KoHuynh/QuadCtrl/images/feedbacksystem.png

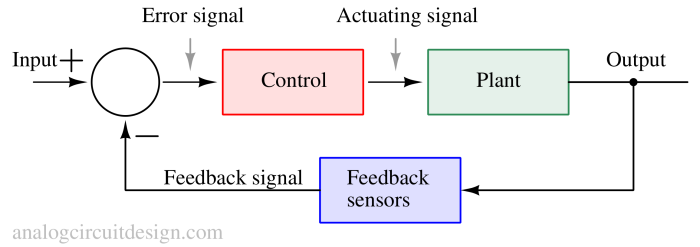
images/feedbacksystem.png
