KoHuynh/QuadCtrl/images/ECE193HQuadCopterShieldSchematicV1.pdf

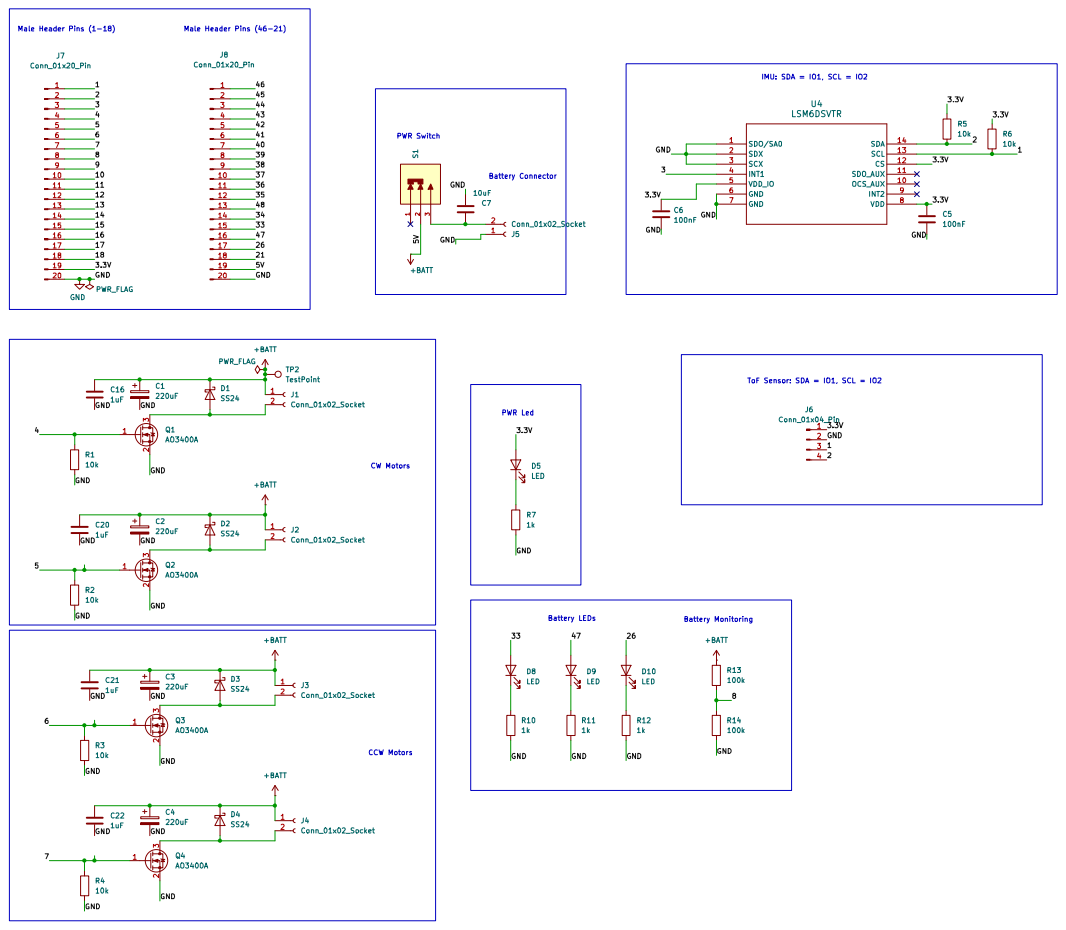
[picture p7: page 1]
