KoHuynh/QuadCtrl/ShieldDesign/ECE193HQuadCopterShieldVer1.kicad_pcb

## KiCad design ShieldDesign/ECE193HQuadCopterShieldVer1.kicad_pcb (2026-10-13)

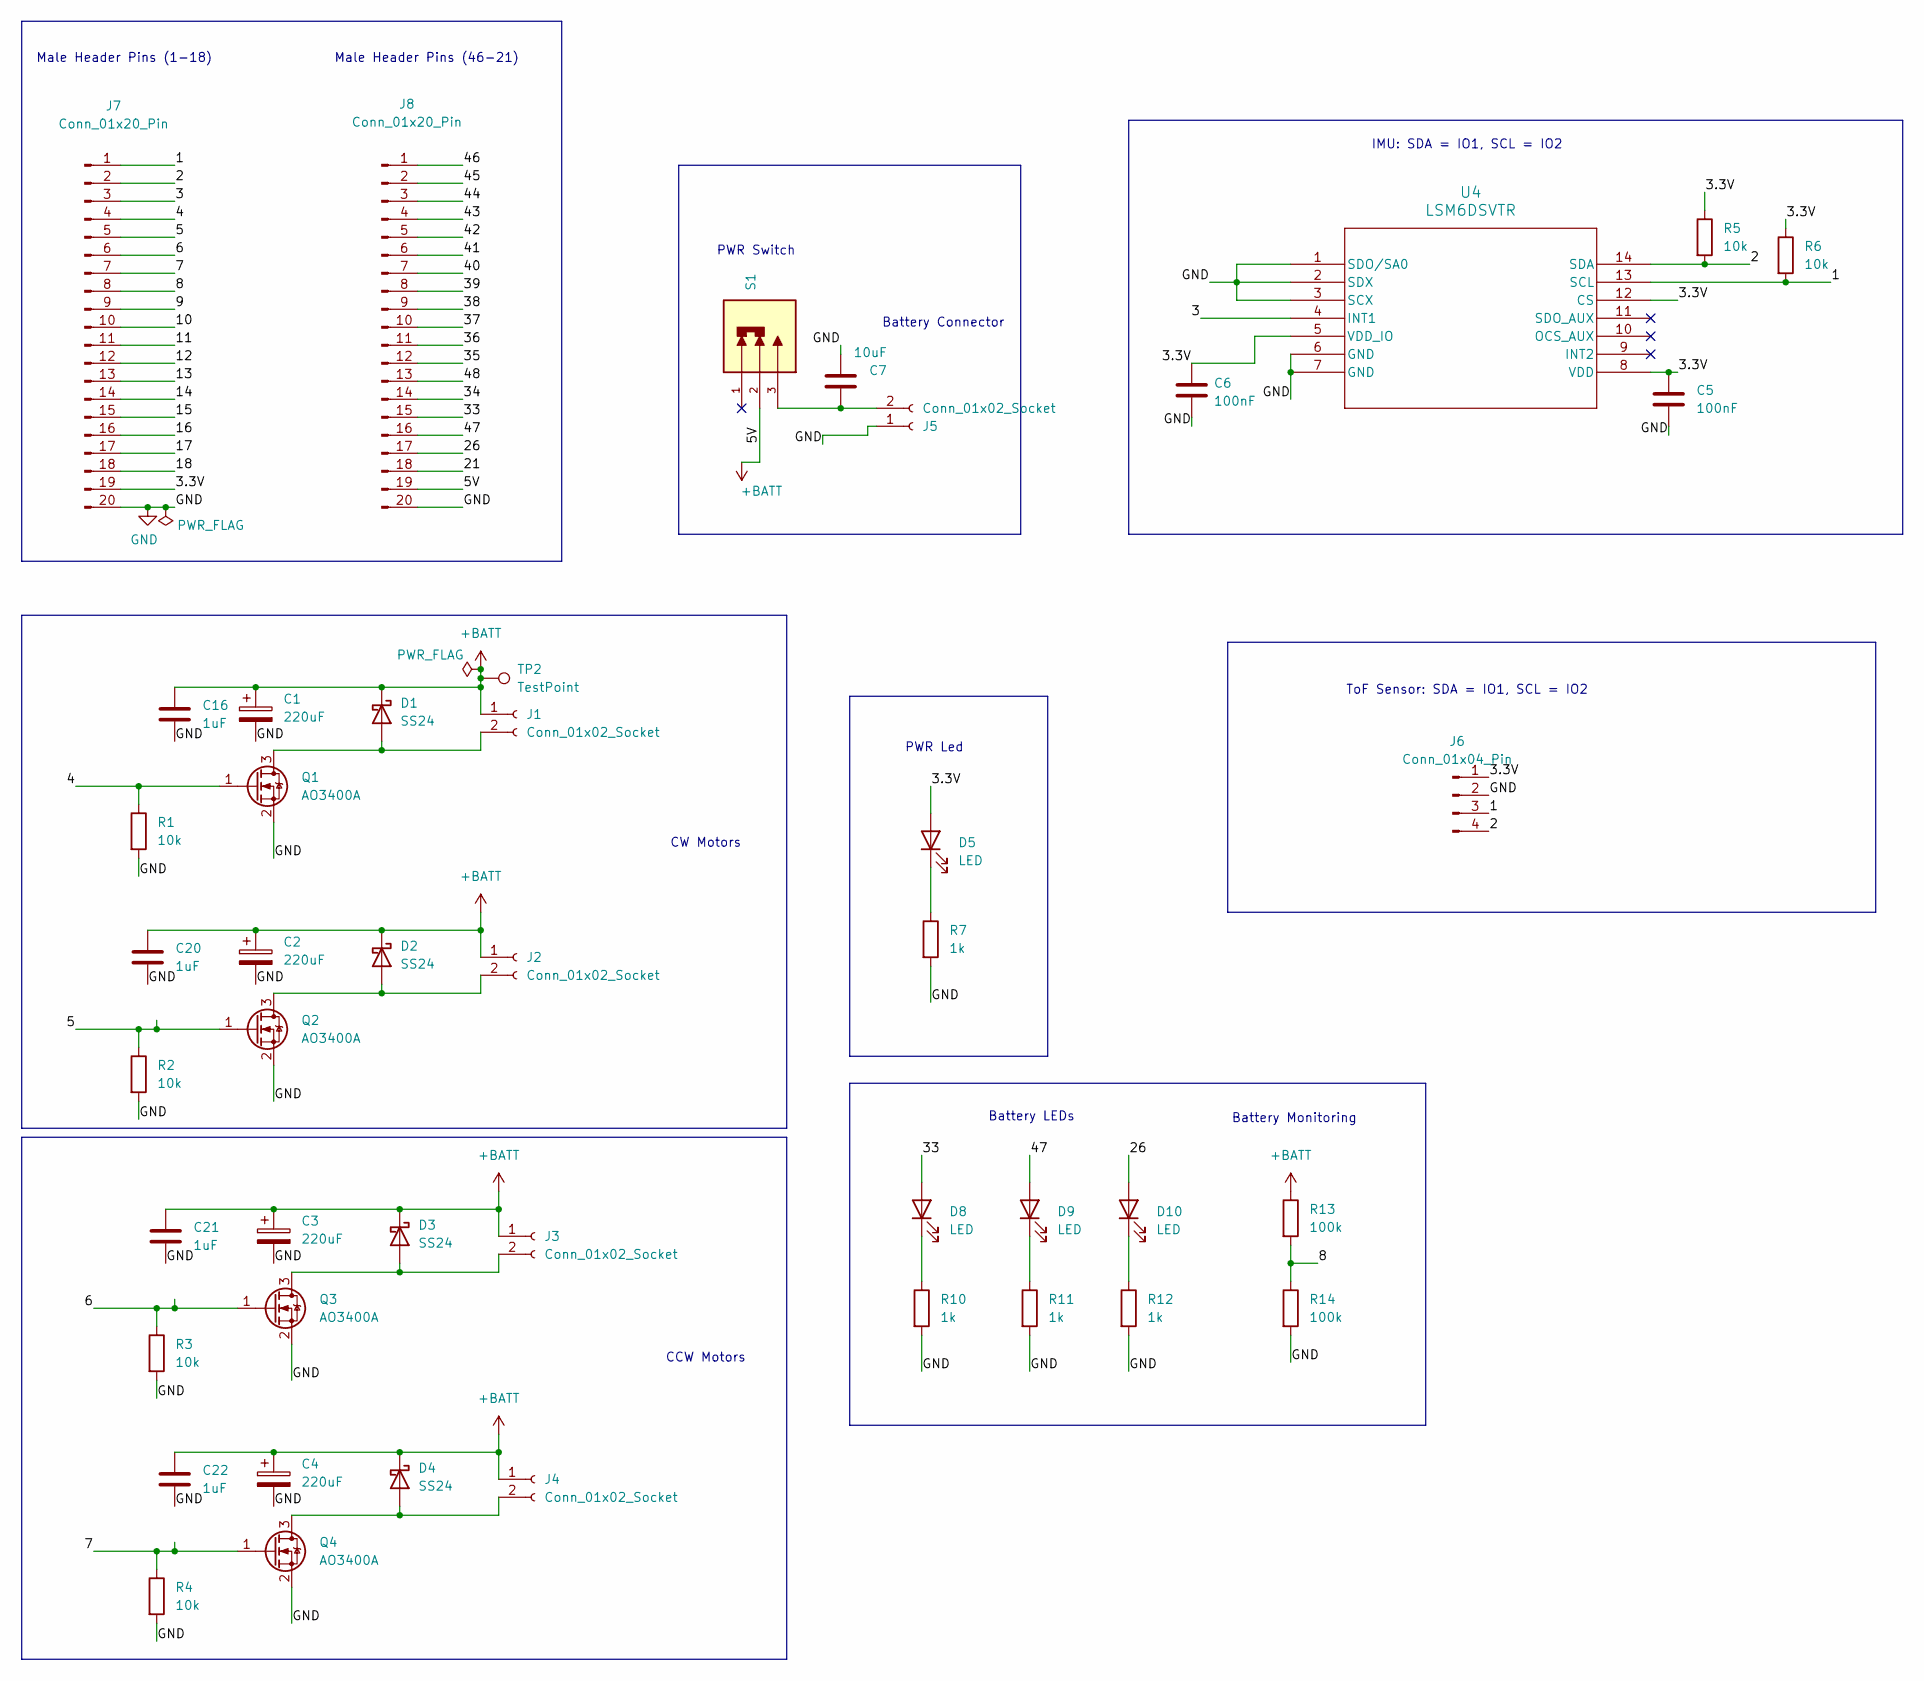
[picture p8: schematic ECE193HQuadCopterShieldVer1.kicad_sch]

Parts:
C1, C2, C3, C4: 220uF; CAP_EEEFK1A221SL
C5, C6: 100nF; C_0805_2012Metric_Pad1.18x1.45mm_HandSolder
C7: 10uF; C_0805_2012Metric_Pad1.18x1.45mm_HandSolder
C16, C20, C21, C22: 1uF; C_0805_2012Metric
D1, D2, D3, D4: SS24; D_SMA
D5, D8, D9, D10: LED; LED_0805_2012Metric
J1, J2, J3, J4, J5: Conn_01x02_Socket; PinHeader_1x02_P2.54mm_Vertical
J6: Conn_01x04_Pin; PinHeader_1x04_P2.54mm_Vertical
J7, J8: Conn_01x20_Pin; PinHeader_1x20_P2.54mm_Vertical
Q1, Q2, Q3, Q4: AO3400A; SOT-23
R1, R2, R3, R4, R5, R6: 10k; R_0805_2012Metric_Pad1.20x1.40mm_HandSolder
R7, R10, R11, R12: 1k; R_0805_2012Metric_Pad1.20x1.40mm_HandSolder
R13, R14: 100k; R_0805_2012Metric_Pad1.20x1.40mm_HandSolder
S1: SLW-105558-2A-N-D; SW_SLW-105558-2A-N-D; PARTREV 1.01
TP2: TestPoint; TestPoint_Pad_D1.0mm
U4: LSM6DSVTR; LGA14-L_2P59X3P1X0P5_STM

Connections:
+BATT: C1.1, C2.1, C3.1, C4.1, C16.1, C20.1, C21.1, C22.1, D1.1 (K), D2.1 (K), D3.1 (K), D4.1 (K), J1.1, J2.1, J3.1, J4.1, J8.19, R13.1, S1.2, TP2.1; also elsewhere on the board
/1: J6.3, J7.1, R6.2, U4.13 (SCL)
/2: J6.4, J7.2, R5.2, U4.14 (SDA)
/3: J7.3, U4.4 (INT1)
/3.3V: C5.1, C6.1, D5.2 (A), J6.1, J7.19, R5.1, R6.1, U4.5 (VDD_IO), U4.8 (VDD), U4.12 (CS)
/4: J7.4, Q1.1 (G), R1.1
/5: J7.5, Q2.1 (G), R2.1
/6: J7.6, Q3.1 (G), R3.1
/7: J7.7, Q4.1 (G), R4.1
/8: J7.8, R13.2, R14.1
/9: J7.9
/10: J7.10
/11: J7.11
/12: J7.12
/13: J7.13
/14: J7.14
/15: J7.15
/16: J7.16
/17: J7.17
/18: J7.18
/21: J8.18
/26: D10.2 (A), J8.17
/33: D8.2 (A), J8.15
/34: J8.14
/35: J8.12
/36: J8.11
/37: J8.10
/38: J8.9
/39: J8.8
/40: J8.7
/41: J8.6
/42: J8.5
/43: J8.4
/44: J8.3
/45: J8.2
/46: J8.1
/47: D9.2 (A), J8.16
/48: J8.13
GND: C1.2, C2.2, C3.2, C4.2, C5.2, C6.2, C7.2, C16.2, C20.2, C21.2, C22.2, J5.1, J6.2, J7.20, J8.20, Q1.2 (S), Q2.2 (S), Q3.2 (S), Q4.2 (S), R1.2, R2.2, R3.2, R4.2, R7.2, R10.2, R11.2, R12.2, R14.2, U4.1 (SDO/SA0), U4.2 (SDX), U4.3 (SCX), U4.6 (GND), U4.7 (GND)
unnamed: D1.2 (A), J1.2, Q1.3 (D)
unnamed: D2.2 (A), J2.2, Q2.3 (D)
unnamed: D3.2 (A), J3.2, Q3.3 (D)
unnamed: D4.2 (A), J4.2, Q4.3 (D)
unnamed: D5.1 (K), R7.1
unnamed: D8.1 (K), R10.1
unnamed: D9.1 (K), R11.1
unnamed: D10.1 (K), R12.1
unnamed: C7.1, J5.2, S1.3

Notes on the sheet:
ToF Sensor: SDA = IO1, SCL = IO2
Male Header Pins (46-21)
CW Motors
IMU: SDA = IO1, SCL = IO2
Battery LEDs
PWR Switch
Battery Connector
PWR Led
CCW Motors
Battery Monitoring
Male Header Pins (1-18)

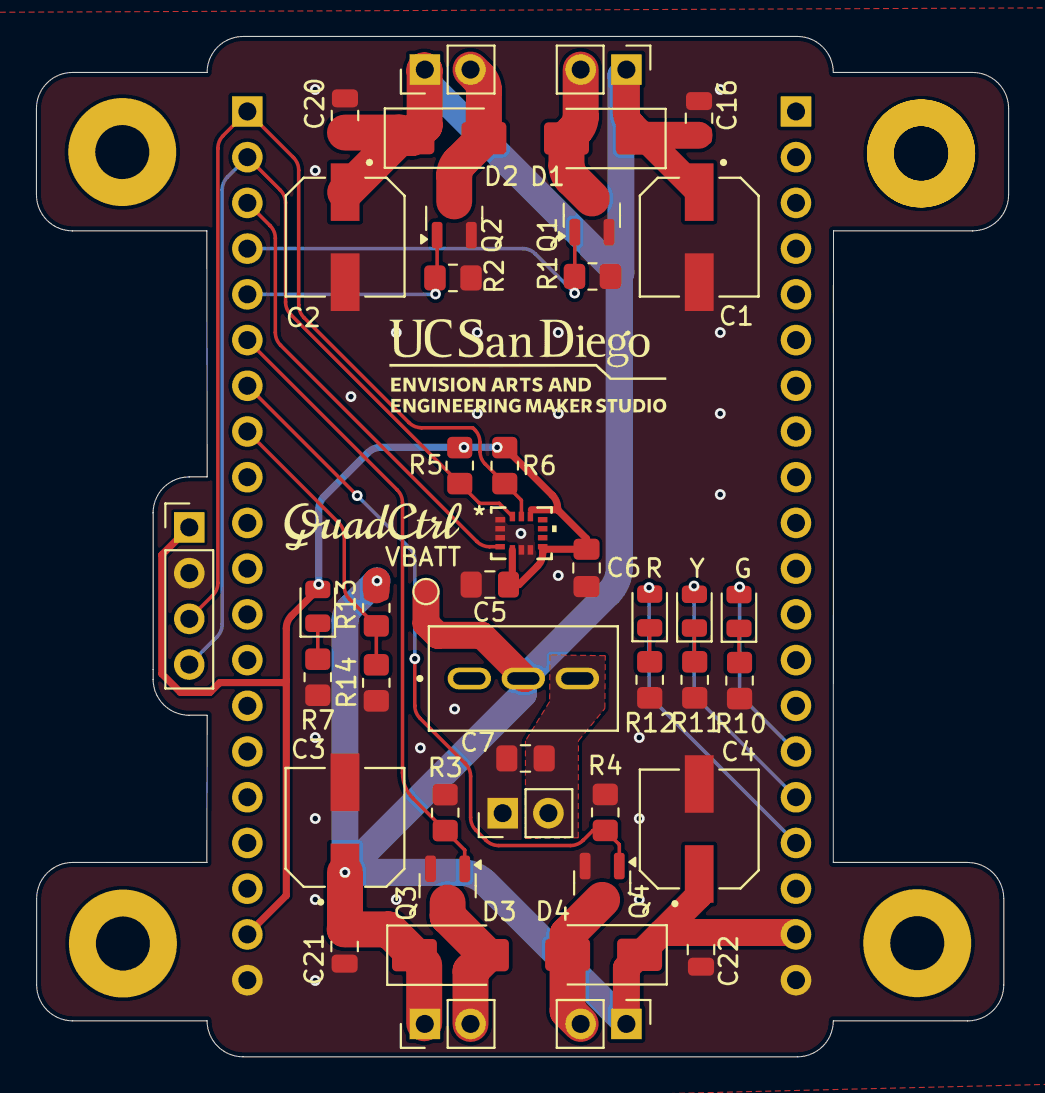
[picture p9: board ECE193HQuadCopterShieldVer1.kicad_pcb from above]

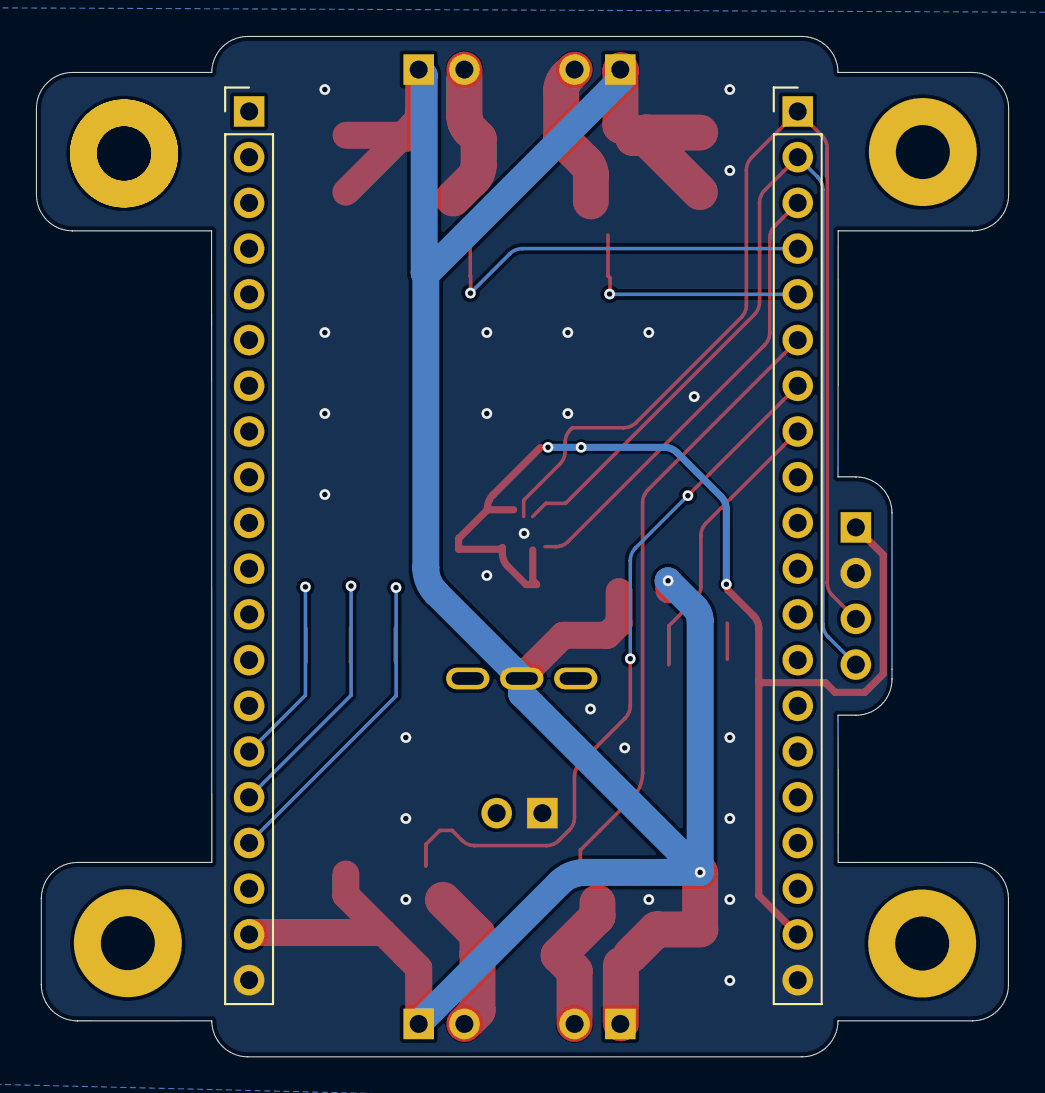
[picture p10: board ECE193HQuadCopterShieldVer1.kicad_pcb from below]

Board: 2 copper layers, 54.0 x 56.7 mm, 46 parts (2 on the bottom side), 23 nets.

Other parts of the board:
VBATT: TestPoint; TestPoint_Pad_D1.0mm

Their connections:
+BATT: VBATT.1; also elsewhere on the board
